itdaniher/thundermaus/thundermaus.brd.png

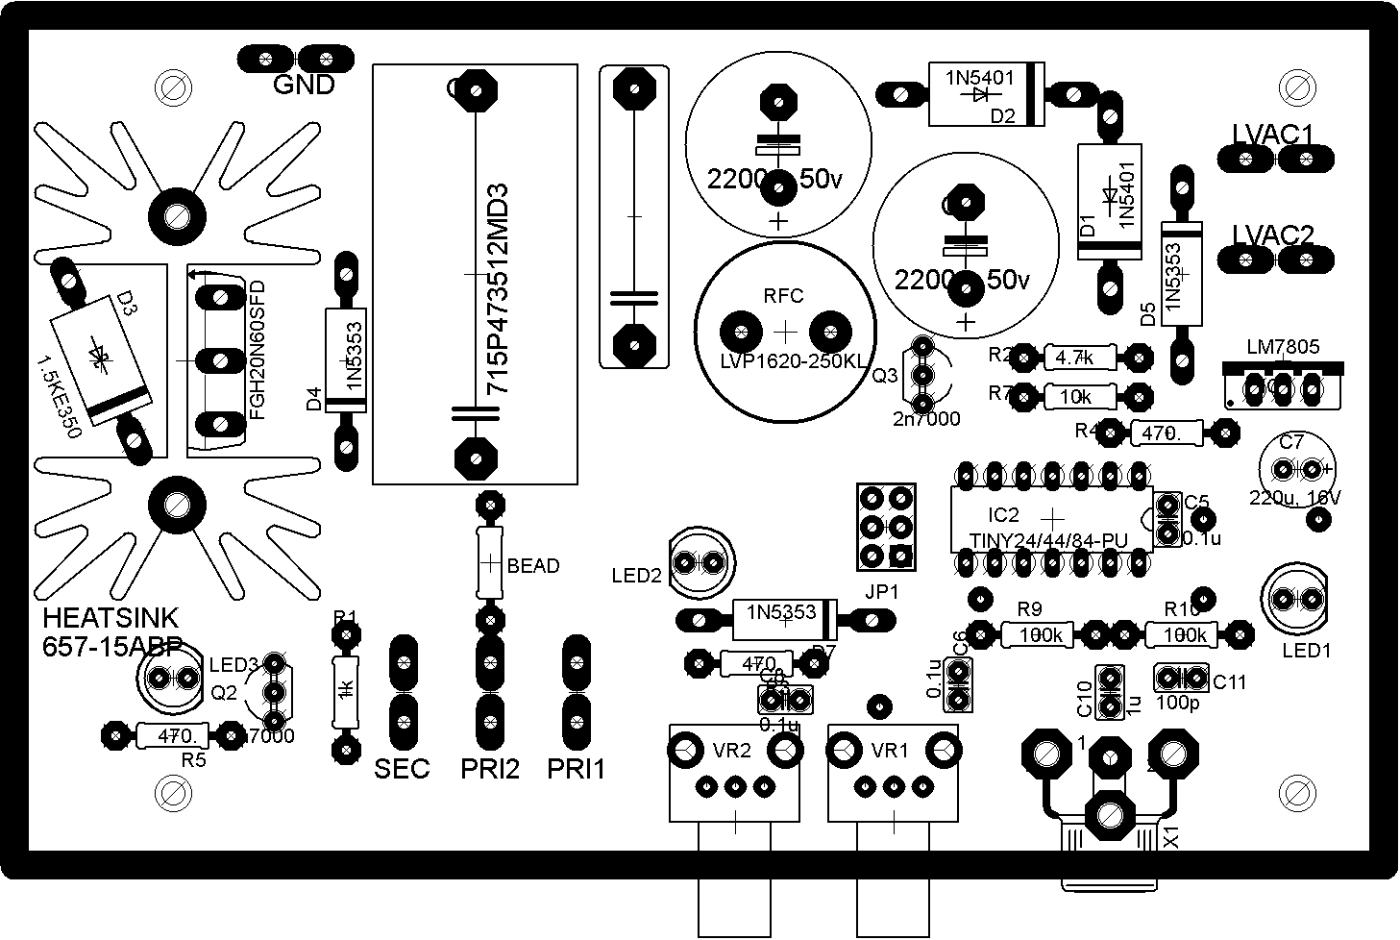
thundermaus.brd.png
