itdaniher/thundermaus/thundermaus.sch.png

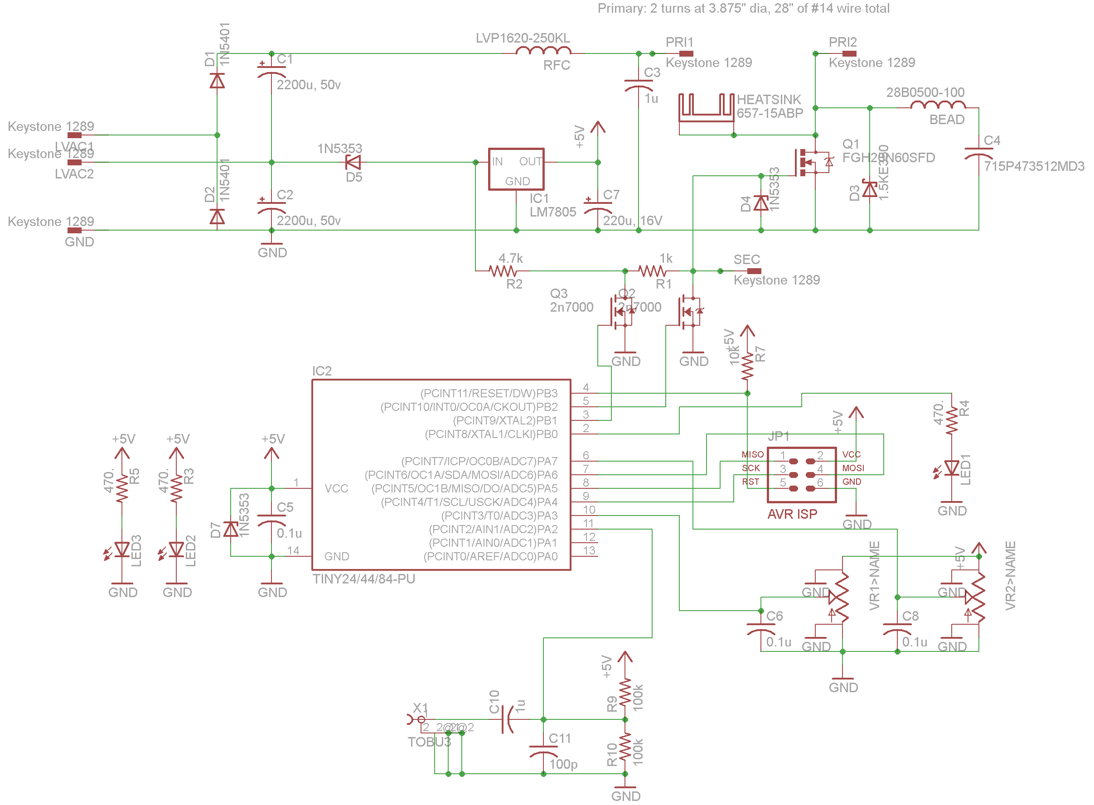
thundermaus.sch.png
