itdaniher/thundermaus/finalCase.dxf

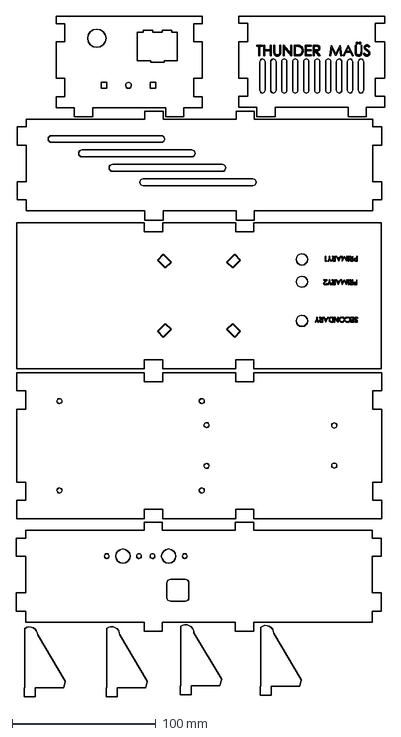
[picture p3: CAD file, 2012-12-13]
finalCase.dxf
256.3 x 473.8 mm
