itdaniher/thundermaus/thundermaus.brd

## EAGLE design thundermaus.brd (2012-12-12)

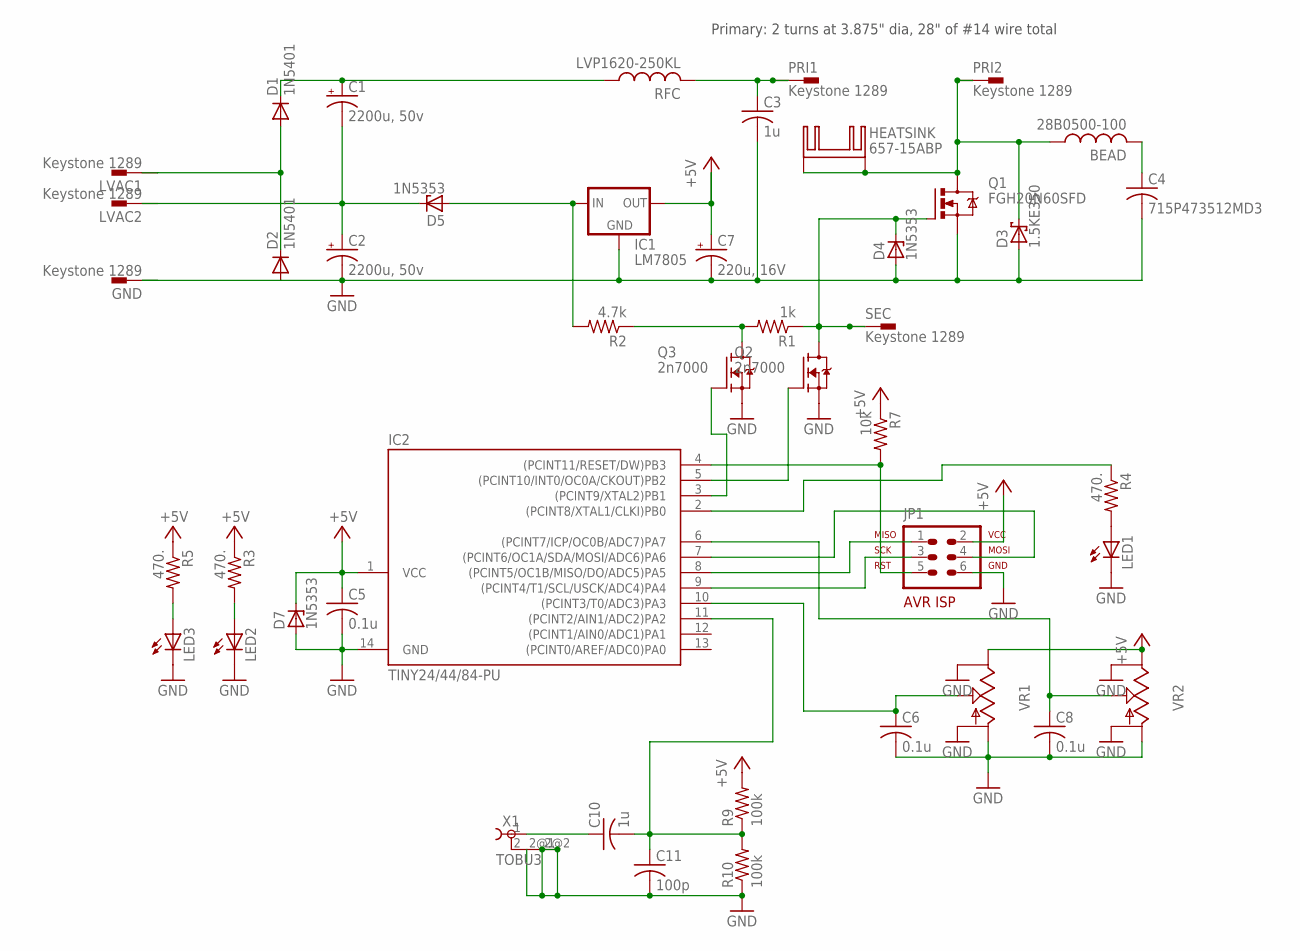
[picture p4: schematic thundermaus.sch]

Parts:
BEAD: 28B0500-100; 0207/10
C1, C2: 2200u, 50v; E7,5-16
C3: 1u; C225-062X268
C4: 715P473512MD3; C325-182X374
C5, C6, C8: 0.1u; C025-025X050
C7: 220u, 16V; E2,5-7
C10: 1u; C025-025X050
C11: 100p; C025-025X050
D1, D2: 1N5401; DO201-15
D3: 1.5KE350; DO201T15
D4, D5, D7: 1N5353; C1702-15
GND: Keystone 1289; F061.060
HEATSINK: 657-15ABP; SK129
IC1: LM7805; 78XXS
IC2: TINY24/44/84-PU; DIL14
JP1: AVR-ISP-6VERT; AVR-ISP-6
LED1, LED2, LED3: LED5MM
LVAC1, LVAC2: Keystone 1289; F061.060
PRI1, PRI2: Keystone 1289; F061.060
Q1: FGH20N60SFD; TO247BV
Q2, Q3: 2n7000; TO237-SW
R1: 1k; 0207/10
R2: 4.7k; 0207/10
R3, R4, R5: 470.; 0207/10
R7: 10k; 0207/10
R9, R10: 100k; 0207/10
RFC: LVP1620-250KL; TJ4-U1
SEC: Keystone 1289; F061.060
VR1, VR2: PTV09
X1: TOBU3

Connections:
5V: C5.1, C7.+, D7.C, IC1.OUT, IC2.1 (VCC), JP1.2, R3.1, R5.1, R7.1, R9.2, VR1.P1 (E), VR2.P1 (E)
16V: D5.A, IC1.IN, R2.2
70VDC: C1.+, D1.C, RFC.1
AUDIO: C10.2, C11.1, IC2.11 ((PCINT2/AIN1/ADC2)PA2), R9.1, R10.2
AUDIO-IN: C10.1, X1.1
COLLECTOR: BEAD.1, D3.C, HEATSINK.A2,5, HEATSINK.B2,5, PRI2.A1 (1), PRI2.A2 (1.1), Q1.D
GATE: D4.C, Q1.G, Q2.1 (D), R1.1, SEC.A1 (1), SEC.A2 (1.1)
GND: C2.-, C3.2, C4.2, C5.2, C6.2, C7.-, C8.2, C11.2, D2.A, D3.A, D4.A, D7.A, GND.A1 (1), GND.A2 (1.1), IC1.GND, IC2.14 (GND), JP1.6, LED1.K (C), LED2.K (C), LED3.K (C), Q1.S, Q2.3 (S), Q3.3 (S), R10.1, VR1.P3 (A), VR1.P$4, VR1.P$5, VR2.P3 (A), VR2.P$4, VR2.P$5, X1.2, X1.2@1 (3), X1.2@2 (4)
HVDC: C3.1, PRI1.A1 (1), PRI1.A2 (1.1), RFC.2
LED: IC2.2 ((PCINT8/XTAL1/CLKI)PB0), R4.1
LED2-P: LED2.A, R3.2
LED3-P: LED3.A, R5.2
LEDP: LED1.A, R4.2
LVAC1: D1.A, D2.C, LVAC1.A1 (1), LVAC1.A2 (1.1)
LVAC2: C1.-, C2.+, D5.C, LVAC2.A1 (1), LVAC2.A2 (1.1)
MISO: IC2.8 ((PCINT5/OC1B/MISO/DO/ADC5)PA5), JP1.1
MOSI: IC2.7 ((PCINT6/OC1A/SDA/MOSI/ADC6)PA6), JP1.4
PA3: C6.1, IC2.10 ((PCINT3/T0/ADC3)PA3), VR1.P2 (S)
PA7: C8.1, IC2.6 ((PCINT7/ICP/OC0B/ADC7)PA7), VR2.P2 (S)
PB1: IC2.3 ((PCINT9/XTAL2)PB1), Q3.2 (G)
PB2: IC2.5 ((PCINT10/INT0/OC0A/CKOUT)PB2), Q2.2 (G)
PULLUP_DISABLE: Q3.1 (D), R1.2, R2.1
RESONANT: BEAD.2, C4.1
RST: IC2.4 ((PCINT11/RESET/DW)PB3), JP1.5, R7.2
SCK: IC2.9 ((PCINT4/T1/SCL/USCK/ADC4)PA4), JP1.3

Notes on the sheet:
Primary: 2 turns at 3.875" dia, 28" of #14 wire total

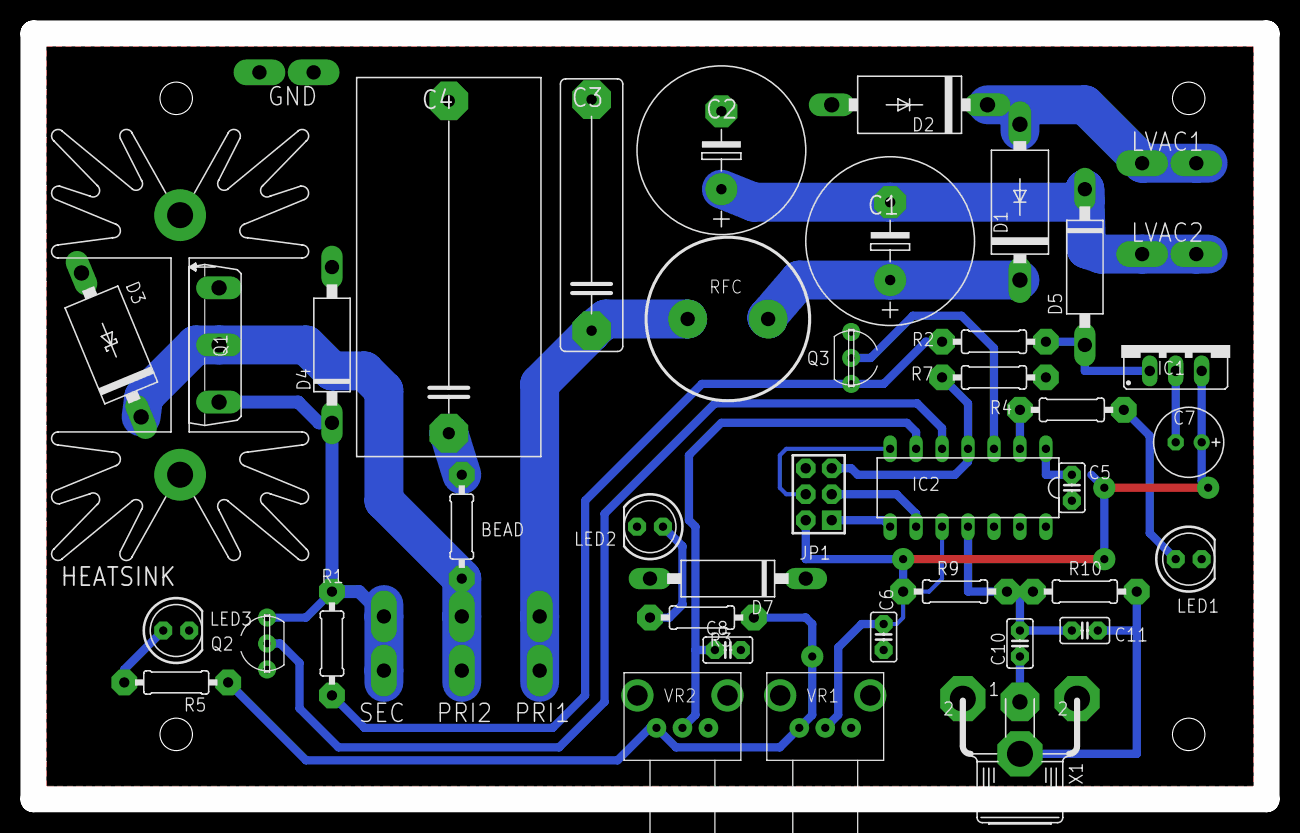
[picture p5: board thundermaus.brd from above]

Board: 2 copper layers, 120.6 x 74.9 mm, 45 parts (0 on the bottom side), 25 nets.
