itdaniher/thundermaus/(commit log)

2012-11-29 initial commit of thundermouse firmware and hardware
    [thundermaus.brd, thundermaus.sch]
2012-11-29 s/rev1/rev2/ - thundermouse with modifications
    [thundermaus.brd, thundermaus.sch]
2012-11-29 added makefile, fixed thundermaus.c usage of _delay_us() macro such that it compiles
    [thundermaus.c]
2012-12-12 update fuse bits to have BOD at right voltage
2012-12-12 name all the things
    [thundermaus.brd, thundermaus.sch]
2012-12-13 add assembly documentation
2012-12-13 added DXF of final case design
    [finalCase.dxf]
2012-12-15 added schematic
